iid1/roost/sub_feeder/3dModel/README.md

# Sub Feeder - 3D Models (ケース・筐体データ)

左手コントローラー（Sub Feeder）のケース、ベースプレート用 CAD / STEP データです。

## ファイル構成
- `step/`:
  - `base.step`: ベースボトムケース STEP モデル
  - `left_device.step`: 全体アセンブリ STEP モデル
  - `left_device_pcb.step`: PCB アセンブリ STEP モデル
  - `left_device.f3d`: Fusion 360 プロジェクトアーカイブ
