iid1/roost/perch/circuit/jlcpcb_smt/wrist_mouse_bom.csv

Designator | Comment | Footprint | LCSC Part #
C1 | 0.1uF | C_0805 | C49970
C2 | 1uF | C_0805 | C28323
C3 | 4.7uF/10V | C_0805 | C15850
C4 | 0.1uF | C_0805 | C49970
R1 | 10k | R_0805 | C17414
R2 | 39R | R_0805 | C17631
R3 | 10k | R_0805 | C17414
U2 | TLV70019DDCR | SOT-23-5 | C2862411
