iid1/roost/perch/3dModel/step/wrist_mouse_cap_v1_4.step

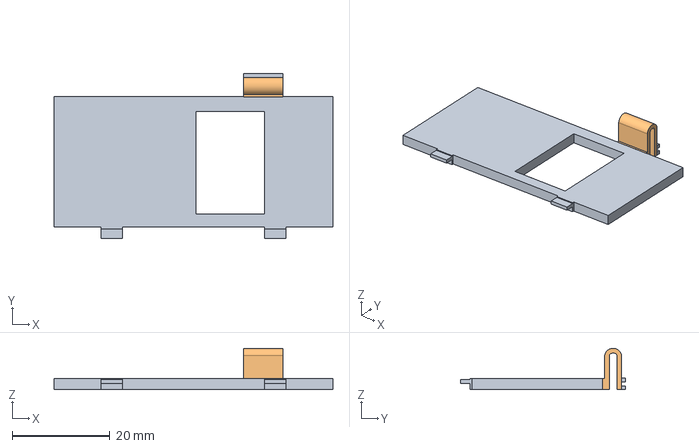
[picture p3: CAD file, 2026-11-03]
perch/3dModel/step/wrist_mouse_cap_v1_4.step
57.2 x 33.8 x 8.50 mm
