iid1/roost/perch/3dModel/stl/wrist_mouse.stl

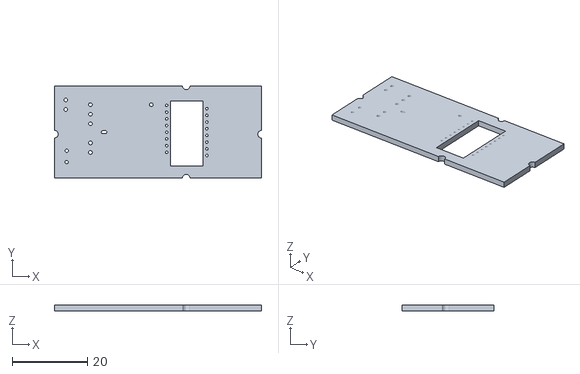
[picture p4: CAD file, 2026-11-03]
perch/3dModel/stl/wrist_mouse.stl
55.0 x 24.5 x 1.51
