iid1/roost/sub_feeder/3dModel/step/left_device_pcb.step

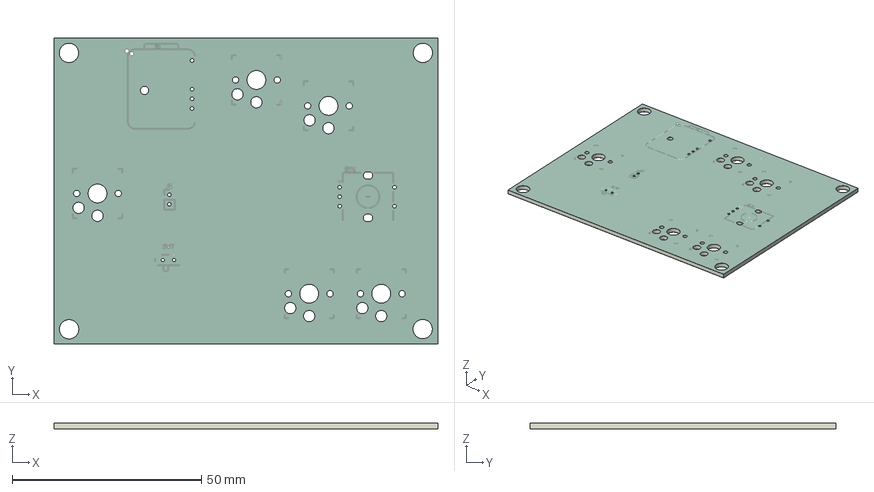
[picture p5: CAD file, 2026-11-03]
sub_feeder/3dModel/step/left_device_pcb.step
101.5 x 81.0 x 1.66 mm
