iid1/roost/sub_feeder/circuit/kicad/left_device.dxf

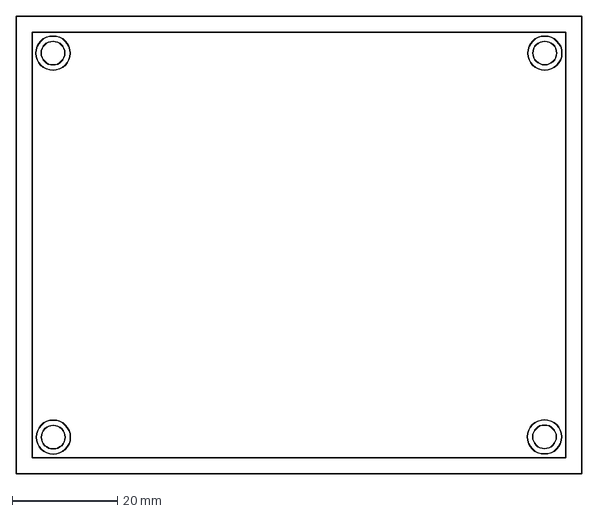
[picture p6: CAD file, 2026-11-03]
sub_feeder/circuit/kicad/left_device.dxf
107.5 x 87.0 mm
