iid1/roost/perch/3dModel/step/wrist_mouse_upper_v1_4.step

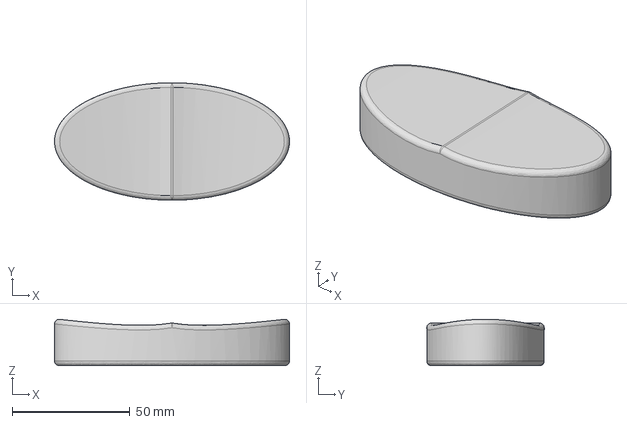
[picture p7: CAD file, 2026-11-03]
perch/3dModel/step/wrist_mouse_upper_v1_4.step
100.0 x 50.0 x 19.7 mm
