iid1/roost/sub_feeder/3dModel/step/base.step

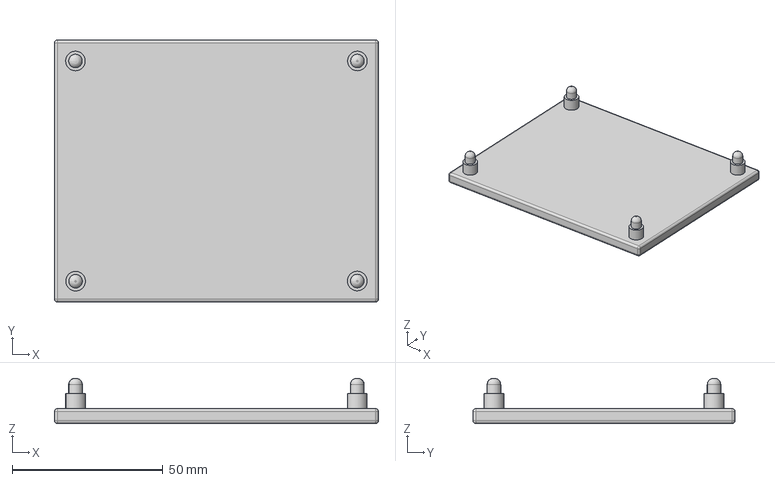
[picture p8: CAD file, 2026-11-03]
sub_feeder/3dModel/step/base.step
107.5 x 87.0 x 15.0 mm
