iid1/roost/perch/3dModel/step/wrist_mouse_pcb.step

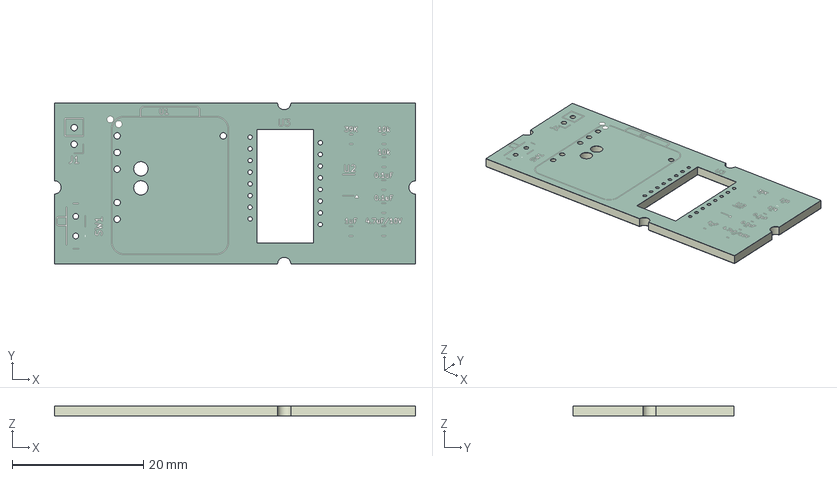
[picture p9: CAD file, 2026-11-03]
perch/3dModel/step/wrist_mouse_pcb.step
55.0 x 24.5 x 1.64 mm
wriEF8F_silkscreen
wriEF8F_soldermask x 2
wriEF8F_PCB
