iid1/roost/perch/3dModel/step/FusionComponent.3mf

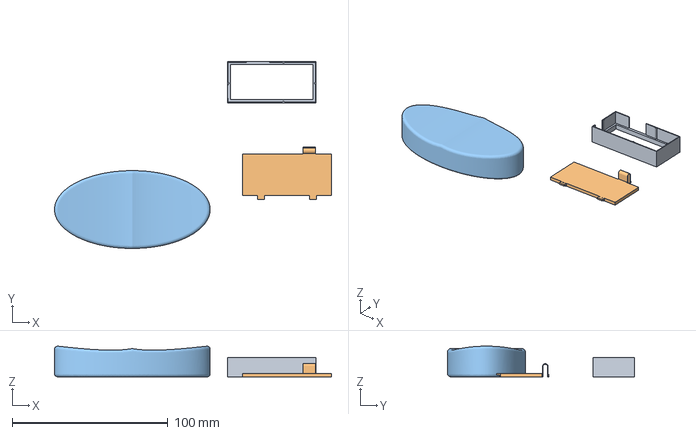
[picture p10: CAD file, 2026-11-03]
perch/3dModel/step/FusionComponent.3mf
178.0 x 120.1 x 19.8 mm
Component_shell
FusionComponent x 2
