iid1/roost/perch/3dModel/step/Component_shell_v_1_3.step

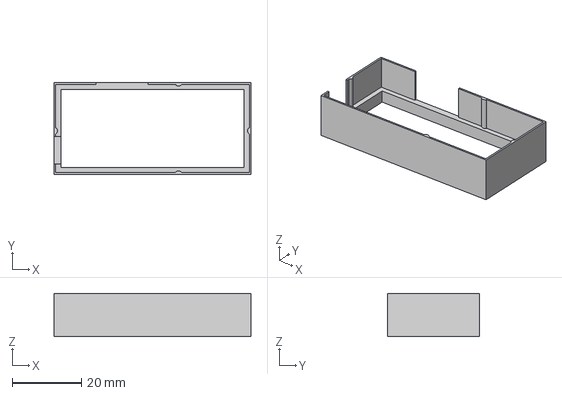
[picture p11: CAD file, 2026-11-03]
perch/3dModel/step/Component_shell_v_1_3.step
57.0 x 26.5 x 12.5 mm
