iid1/roost/(list of files, cad)

Other CAD files:
sub_feeder/3dModel/step/left_device.f3d
