iid1/roost/perch/circuit/kicad/wrist_mouse.kicad_pcb

## KiCad design perch/circuit/kicad/wrist_mouse.kicad_pcb (2026-11-03)

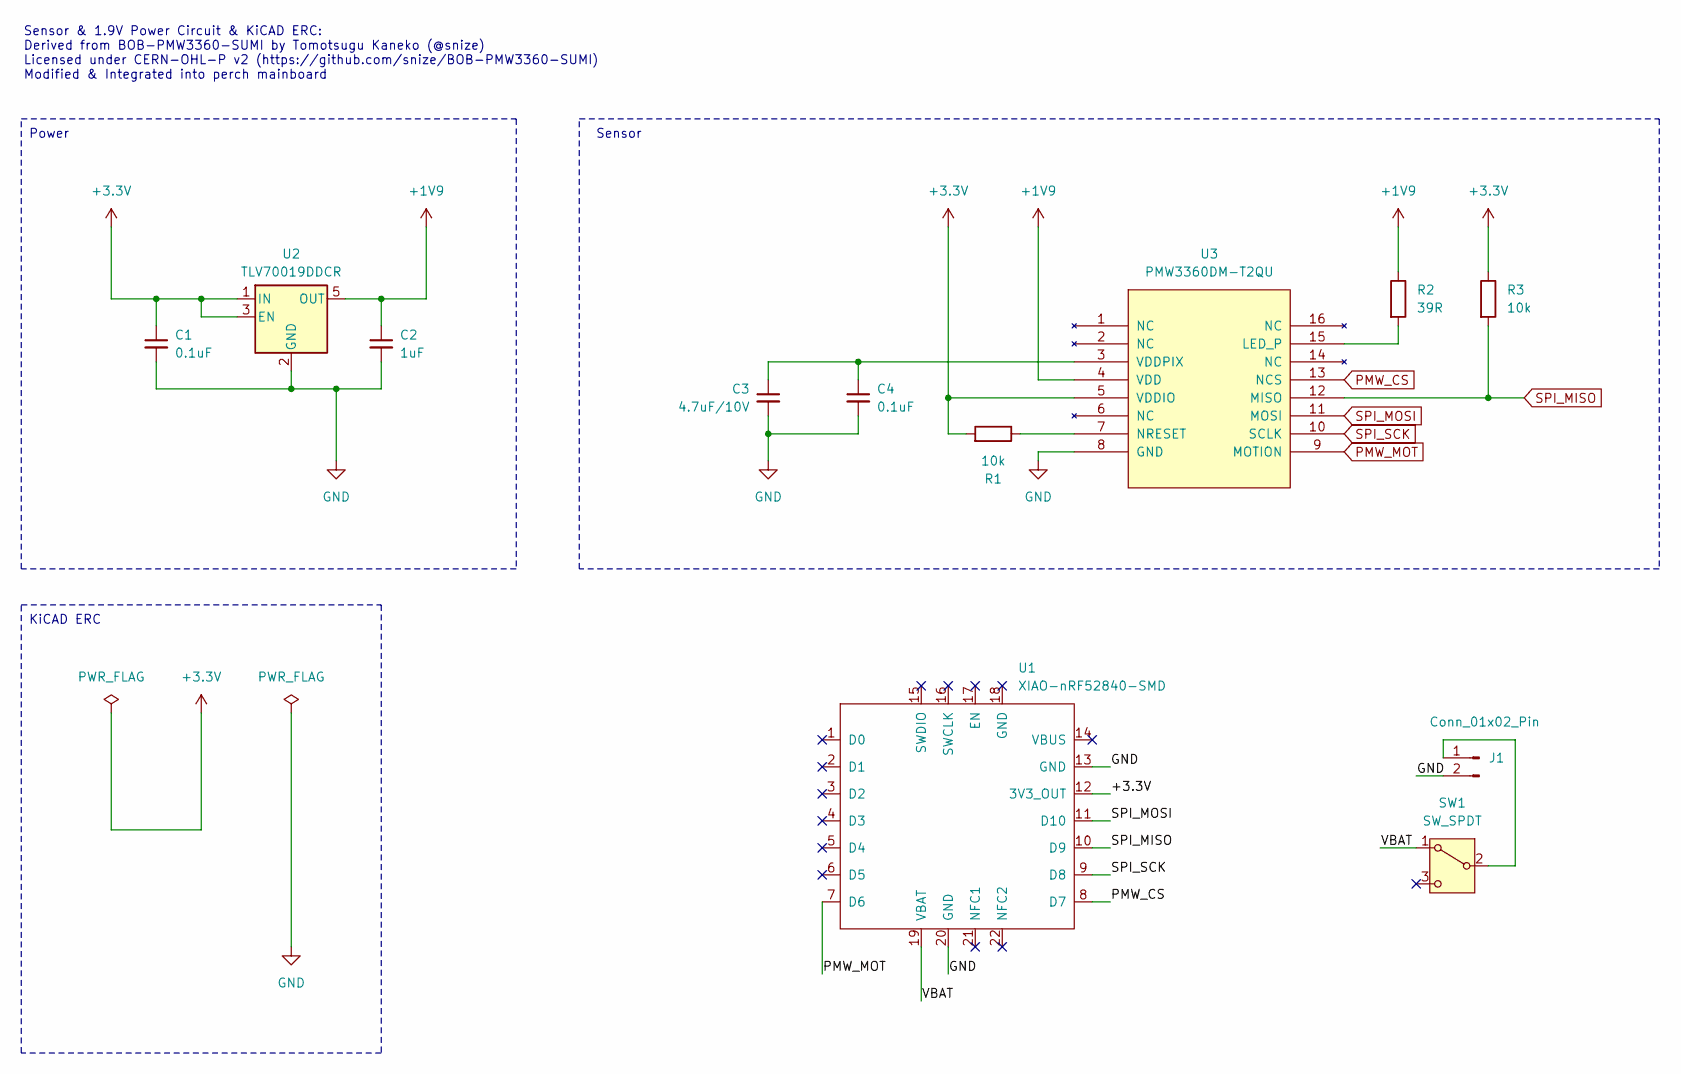
[picture p12: schematic wrist_mouse.kicad_sch]

Parts:
C1, C4: 0.1uF; C_0805_2012Metric_Pad1.18x1.45mm_HandSolder
C2: 1uF; C_0805_2012Metric_Pad1.18x1.45mm_HandSolder
C3: 4.7uF/10V; C_0805_2012Metric_Pad1.18x1.45mm_HandSolder
J1: Conn_01x02_Pin; PinHeader_1x02_P2.54mm_Vertical
R1, R3: 10k; R_0805_2012Metric_Pad1.20x1.40mm_HandSolder
R2: 39R; R_0805_2012Metric_Pad1.20x1.40mm_HandSolder
SW1: SW_SPDT; SW_SPDT_PCM12
U1: XIAO-nRF52840-SMD
U2: TLV70019DDCR; SOT-23-5_HandSoldering
U3: PMW3360DM-T2QU

Connections:
+1V9: C2.1, R2.1, U2.5 (OUT), U3.4 (VDD)
+3.3V: C1.1, R1.2, R3.1, U1.12 (3V3_OUT), U2.1 (IN), U2.3 (EN), U3.5 (VDDIO)
/VBAT: SW1.1 (A), U1.19 (VBAT)
GND: C1.2, C2.2, C3.2, C4.2, J1.2, U1.13 (GND), U1.20 (GND), U2.2 (GND), U3.8 (GND)
unnamed: J1.1, SW1.2 (B)
unnamed: R2.2, U3.15 (LED_P)
unnamed: R1.1, U3.7 (NRESET)
unnamed: C3.1, C4.1, U3.3 (VDDPIX)
PMW_CS: U1.8 (D7), U3.13 (NCS)
PMW_MOT: U1.7 (D6), U3.9 (MOTION)
SPI_MISO: R3.2, U1.10 (D9), U3.12 (MISO)
SPI_MOSI: U1.11 (D10), U3.11 (MOSI)
SPI_SCK: U1.9 (D8), U3.10 (SCLK)

Notes on the sheet:
Sensor
Sensor & 1.9V Power Circuit & KiCAD ERC: Derived from BOB-PMW3360-SUMI by Tomotsugu Kaneko (@snize) Licensed under CERN-OHL-P v2 (https://github.com/snize/BOB-PMW3360-SUMI) Modified & Integrated into perch mainboard
KiCAD ERC
Power

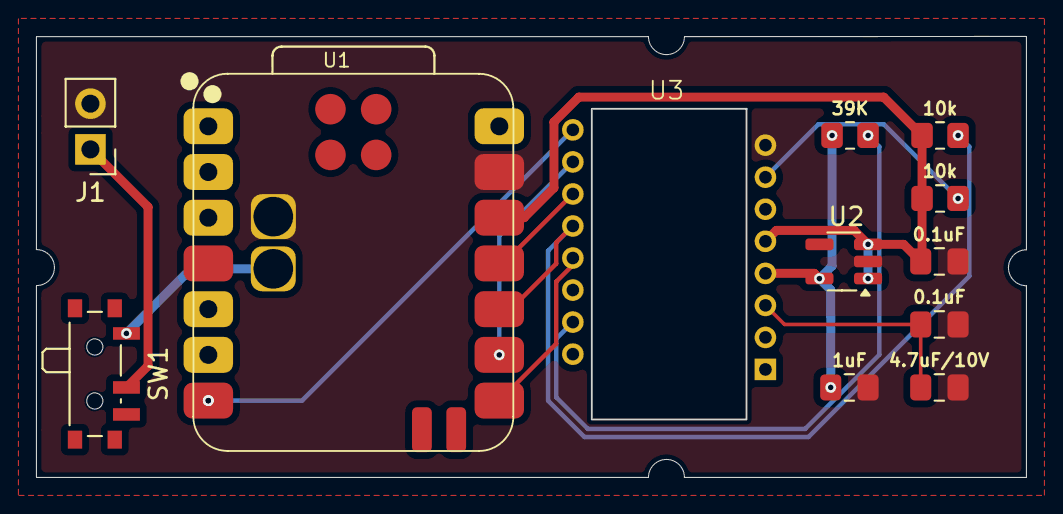
[picture p13: board wrist_mouse.kicad_pcb from above]

Board: 2 copper layers, 55.0 x 24.5 mm, 12 parts (0 on the bottom side), 13 nets.
