iid1/roost/sub_feeder/circuit/kicad/left_device.kicad_pcb

## KiCad design sub_feeder/circuit/kicad/left_device.kicad_pcb (2026-11-03)

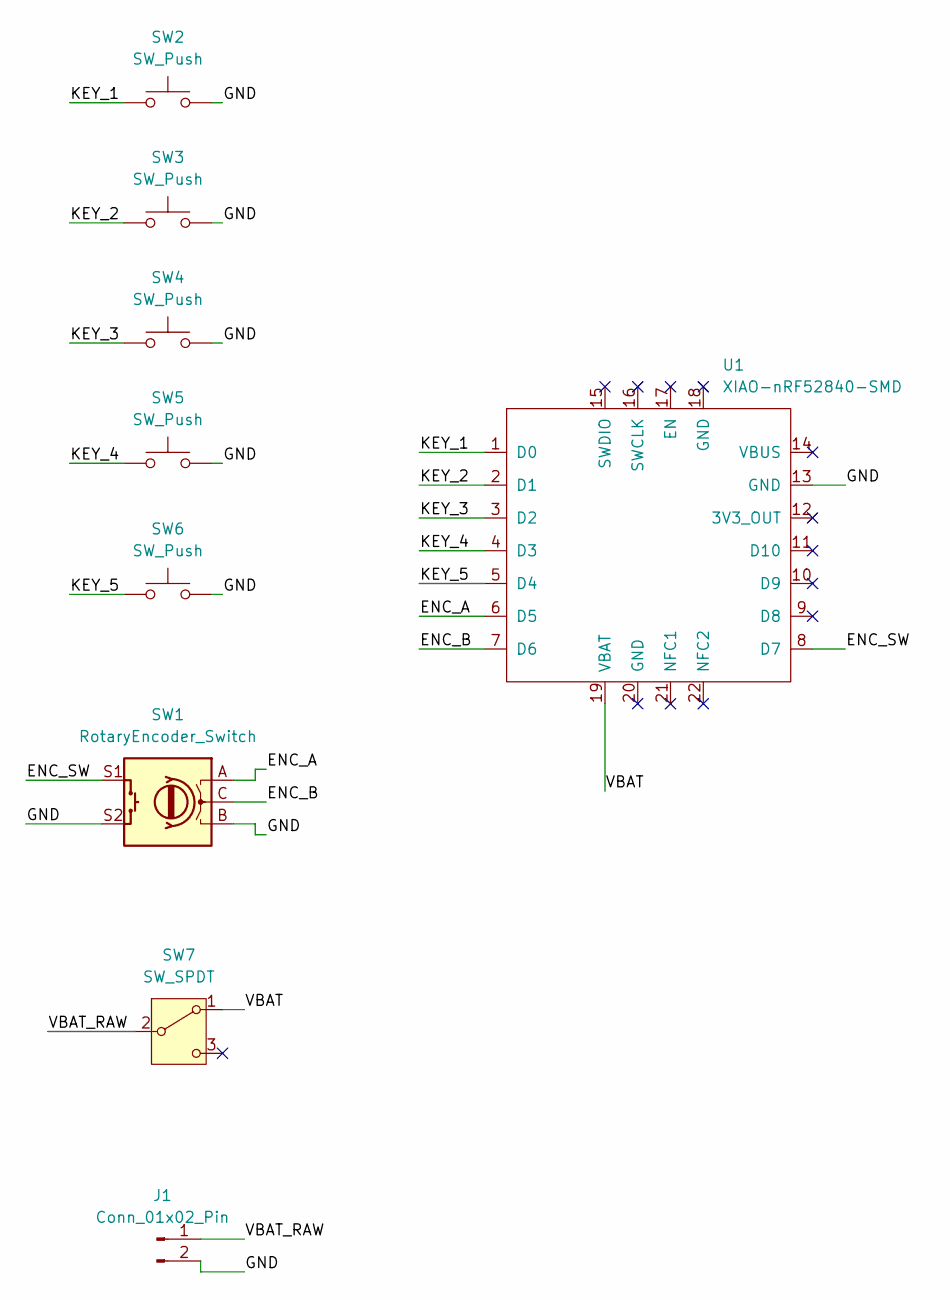
[picture p14: schematic left_device.kicad_sch]

Parts:
J1: Conn_01x02_Pin; PinHeader_1x02_P2.54mm_Vertical
SW1: RotaryEncoder_Switch; RotaryEncoder_Alps_EC12E-Switch_Vertical_H20mm
SW2, SW3, SW4, SW5, SW6: SW_Push; SW_Kailh_Choc_V1V2_HotSwap_Hybrid
SW7: SW_SPDT; SW_SPDT_PCM12
U1: XIAO-nRF52840-SMD

Connections:
/ENC_A: SW1.A, U1.6 (D5)
/ENC_B: SW1.C, U1.7 (D6)
/ENC_SW: SW1.S1, U1.8 (D7)
/GND: J1.2, SW1.B, SW1.S2, SW2.2, SW3.2, SW4.2, SW5.2, SW6.2, U1.13 (GND)
/KEY_1: SW2.1, U1.1 (D0)
/KEY_2: SW3.1, U1.2 (D1)
/KEY_3: SW4.1, U1.3 (D2)
/KEY_4: SW5.1, U1.4 (D3)
/KEY_5: SW6.1, U1.5 (D4)
/VBAT: SW7.1 (A), U1.19 (VBAT)
/VBAT_RAW: J1.1, SW7.2 (B)

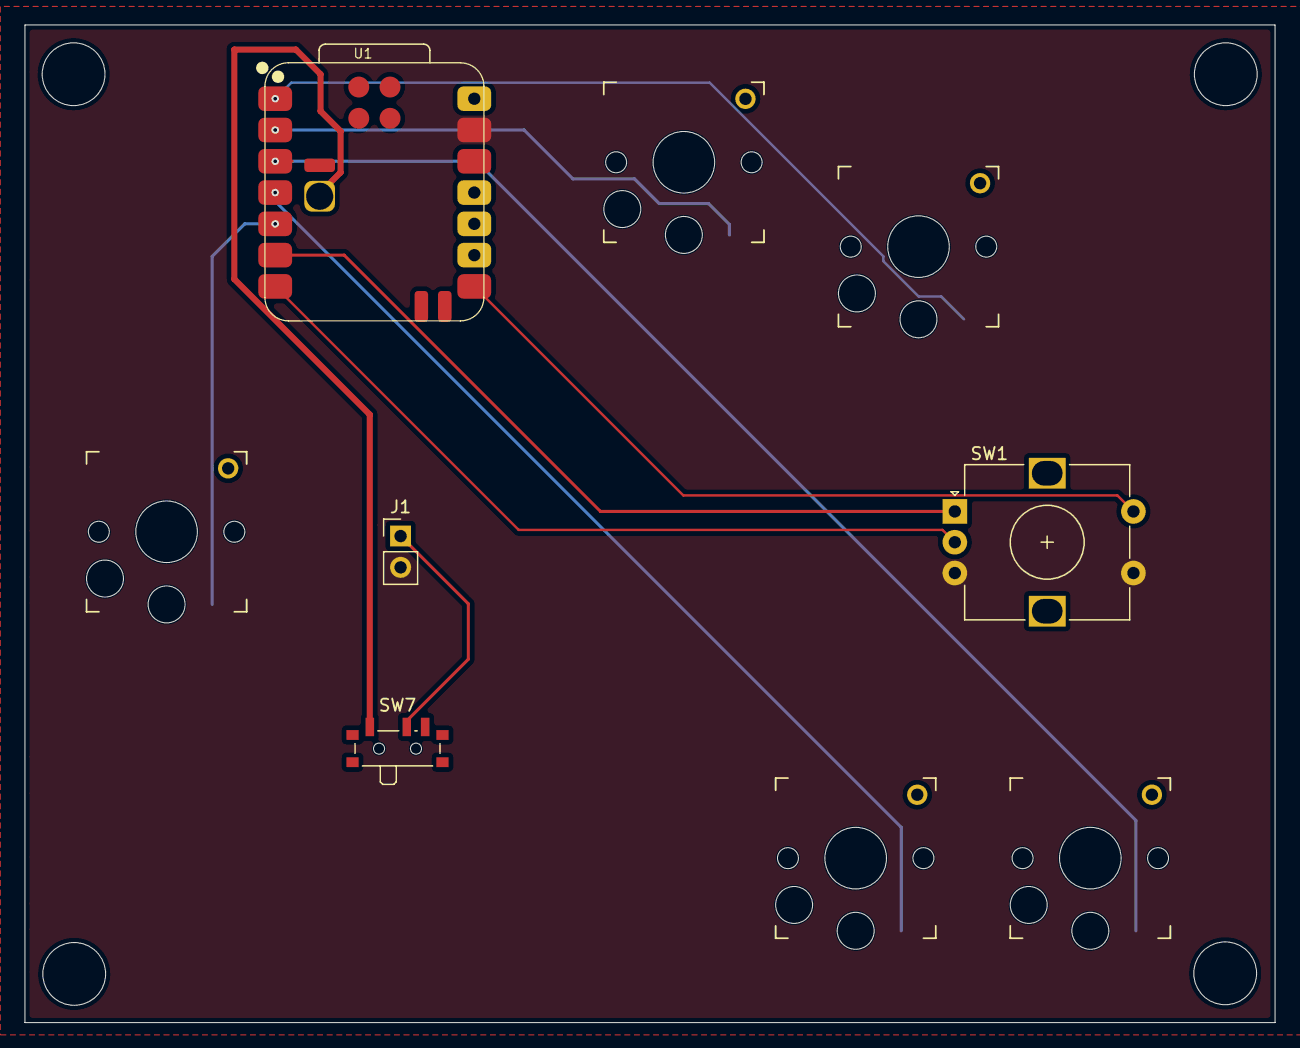
[picture p15: board left_device.kicad_pcb from above]

Board: 2 copper layers, 101.5 x 81.0 mm, 9 parts (0 on the bottom side), 11 nets.
