iid1/roost/(notices)

Notices in the files:
README.md:
License: CERN-OHL-P-2.0
